sebgle/SolBuddy/README.md

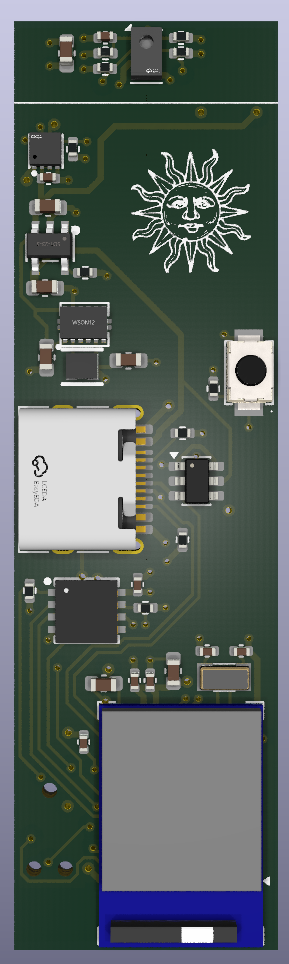
[picture p1: pcb/front_pcb.png]
Front of the pcb

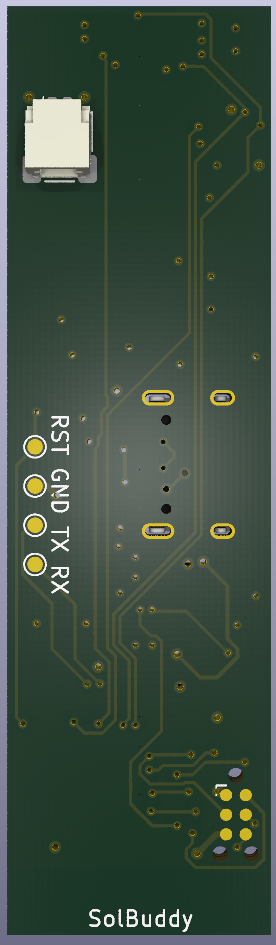
[picture p2: pcb/back_pcb.png]
Back of the pcb

Side of the pcb
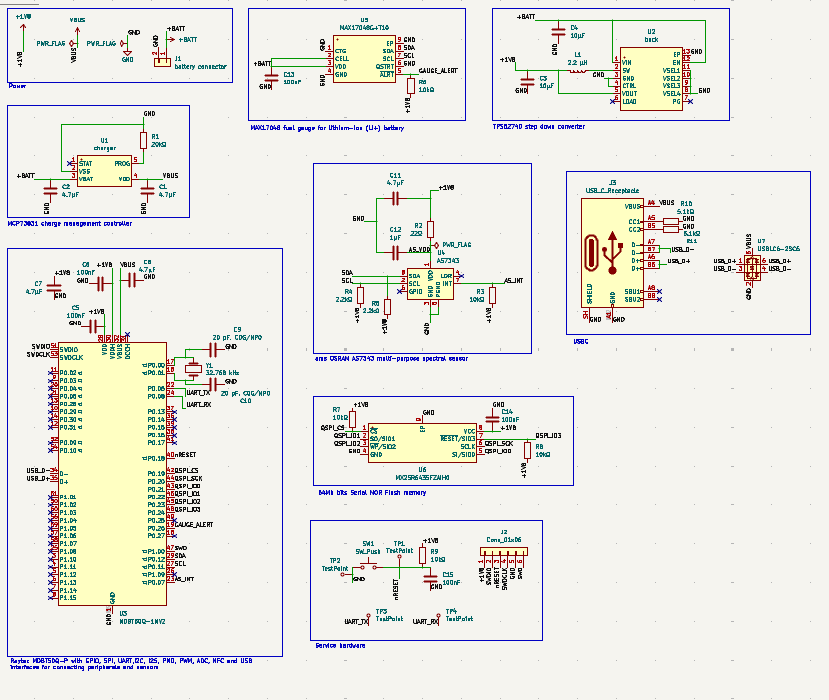
[picture p3: pcb/schematic.png]
Schematic

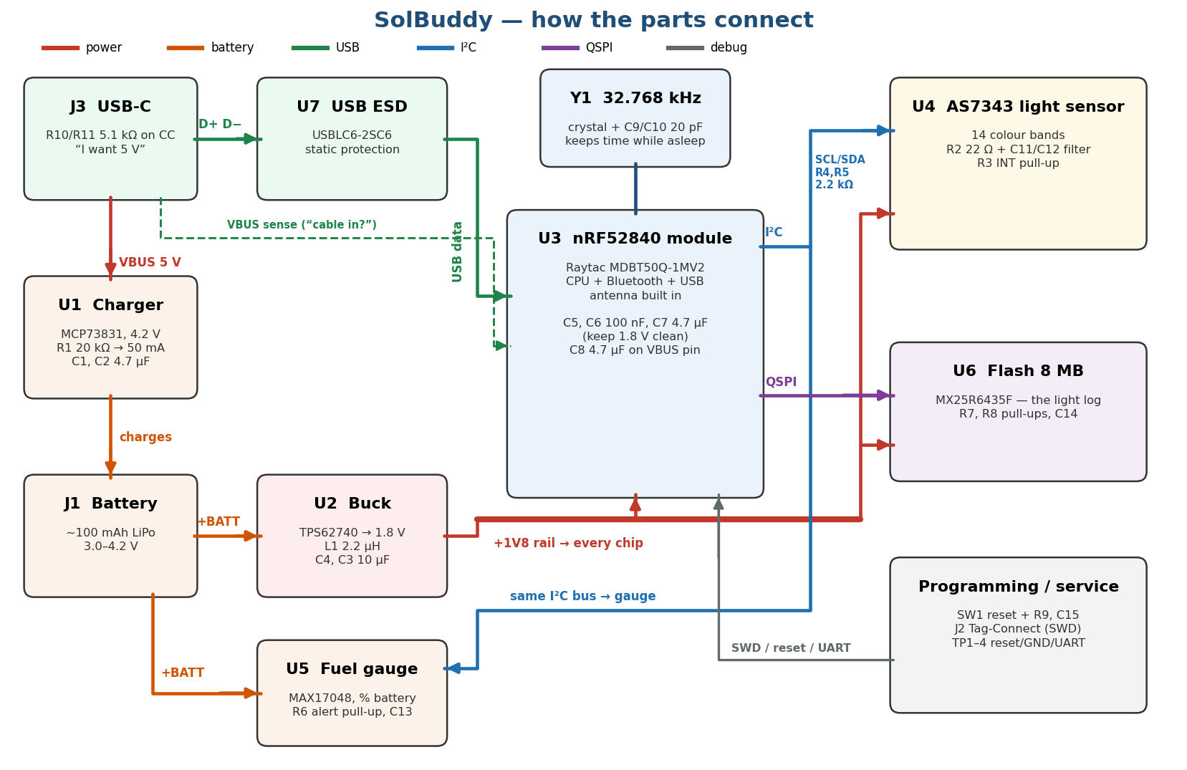
[picture p4: pcb/solbuddy_block_diagram.png]
Block diagram
