sebgle/SolBuddy/code/docs/solbuddy_software_diagram.png

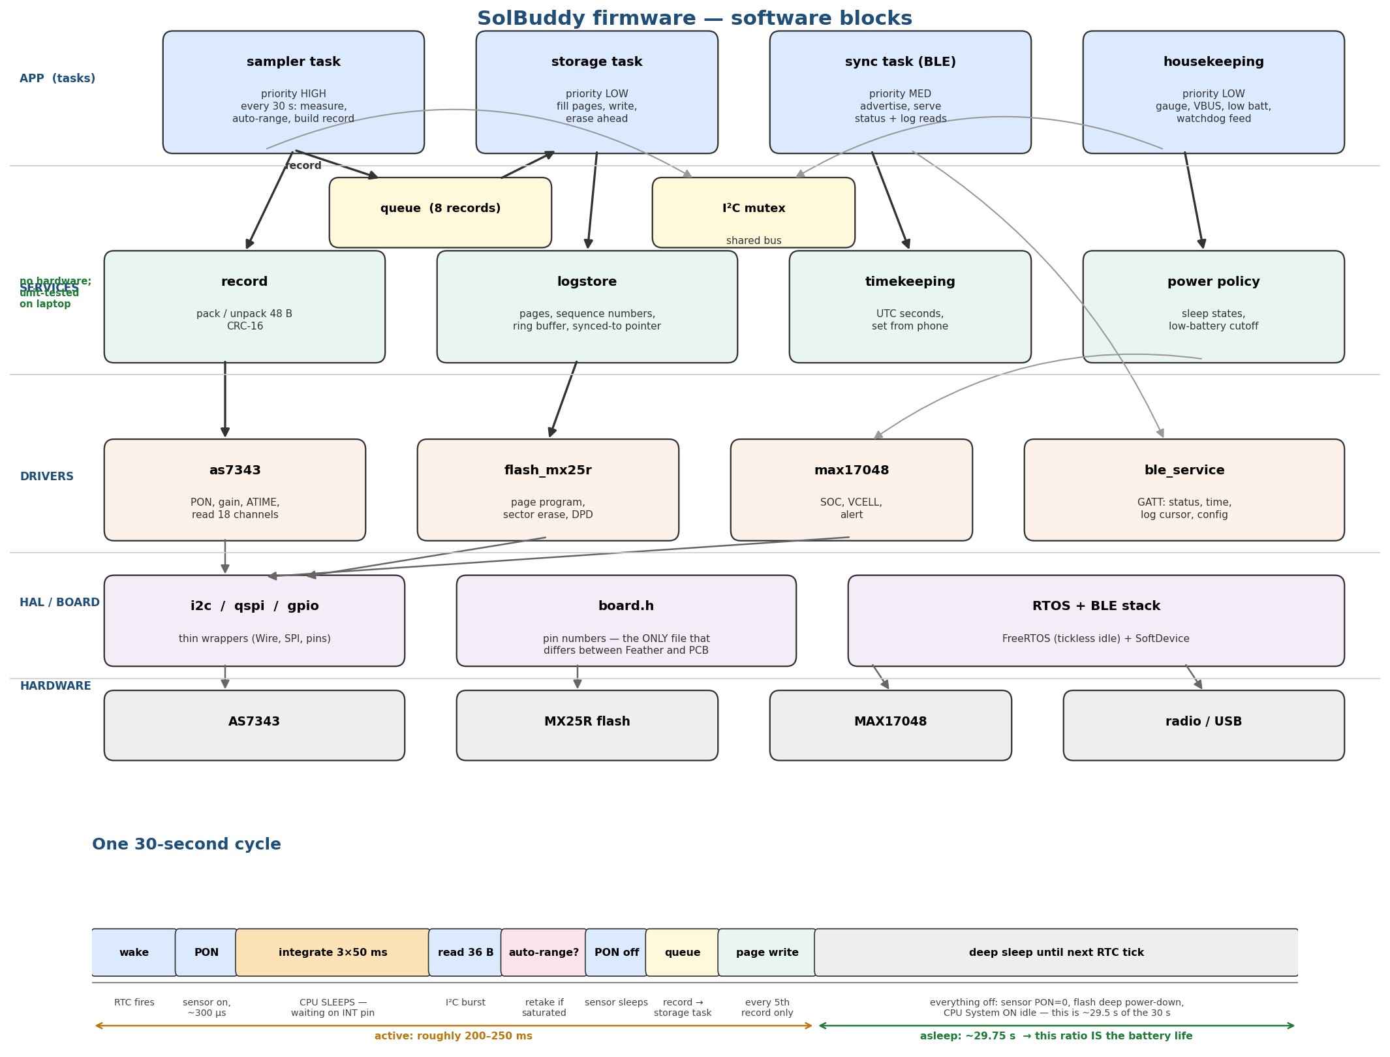
code/docs/solbuddy_software_diagram.png
