sebgle/SolBuddy/pcb/revA/revA.kicad_pcb

## KiCad design pcb/revA/revA.kicad_pcb (2026-09-25)

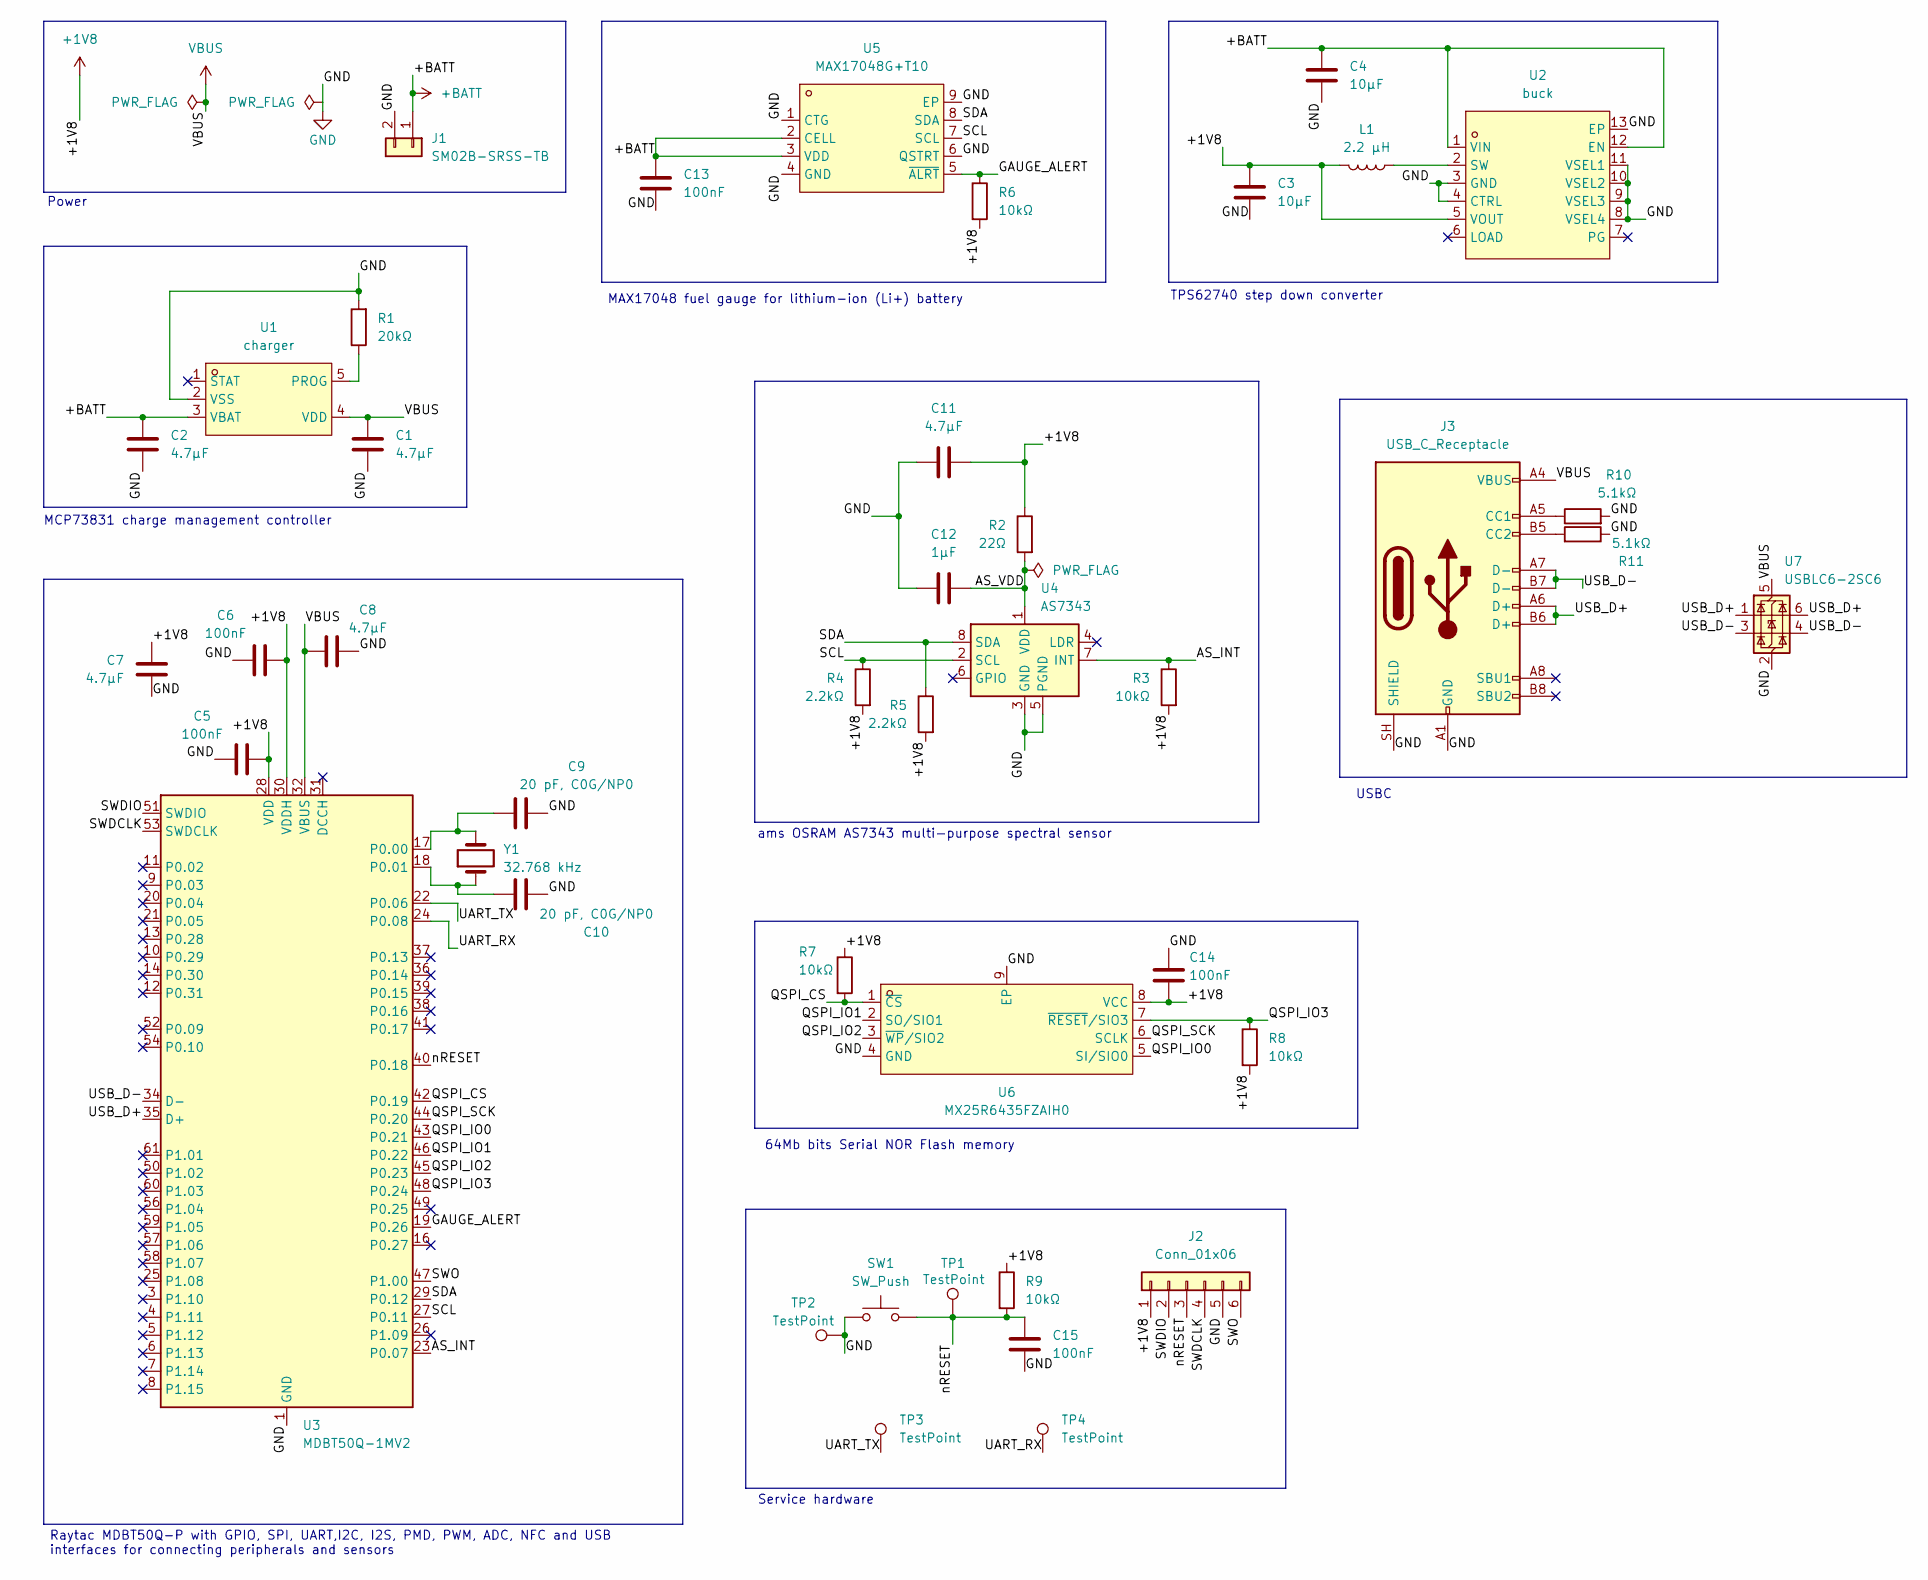
[picture p6: schematic revA.kicad_sch]

Parts:
C1, C2, C7, C8, C11: 4.7µF; C_0603_1608Metric; LCSC C19666
C3, C4: 10µF; C_0603_1608Metric; LCSC C96446
C5, C6, C13, C14, C15: 100nF; C_0402_1005Metric; LCSC C1525
C9, C10: 20 pF, C0G/NP0; C_0402_1005Metric; LCSC C1554
C12: 1µF; C_0402_1005Metric; LCSC C52923
J1: SM02B-SRSS-TB; JST_PH_S2B-PH-SM4-TB_1x02-1MP_P2.00mm_Horizontal; LCSC C295747
J2: Conn_01x06; Tag-Connect_TC2030-IDC-NL_2x03_P1.27mm_Vertical
J3: USB_C_Receptacle; USB_C_Receptacle_HRO_TYPE-C-31-M-12; LCSC C165948
L1: 2.2 µH; IND-SMD_L2.0-W1.6-B; LCSC C5832344
R1: 20kΩ; R_0402_1005Metric; LCSC C25765
R2: 22Ω; R_0402_1005Metric; LCSC C25092
R3, R6, R7, R8, R9: 10kΩ; R_0402_1005Metric; LCSC C25744
R4, R5: 2.2kΩ; R_0402_1005Metric; LCSC C25879
R10, R11: 5.1kΩ; R_0402_1005Metric; LCSC C25905
SW1: SW_Push; SW-SMD_L3.9-W3.0-P4.45; LCSC C720477
TP1, TP2, TP3, TP4: TestPoint; TestPoint_Pad_D1.0mm
U1: charger; SOT-23-5_L3.0-W1.7-P0.95-LS2.8-BL; MPN MCP73831T-2ACI/OT; LCSC C424093
U2: buck; WSON-12_L3.0-W2.0-P0.50-BL-EP; MPN TPS62740DSSR; LCSC C128606
U3: MDBT50Q-1MV2; Raytac_MDBT50Q; LCSC C5118826
U4: AS7343; AMS_OLGA-8_2x3.1mm_P0.8mm; LCSC C19085986
U5: MAX17048G+T10; TDFN-8_L2.0-W2.0-P0.50-BL-EP1.2; MPN MAX17048G+T10; LCSC C2682616
U6: MX25R6435FZAIH0; USON-8_L4.0-W4.0-P0.80-BL-EP; MPN MX25R6435FZAIH0; LCSC C2802846
U7: USBLC6-2SC6; SOT-23-6; LCSC C7519
Y1: 32.768 kHz; Crystal_SMD_3215-2Pin_3.2x1.5mm; LCSC C130253

Connections:
+1V8: C3.1, C5.1, C6.2, C7.2, C11.1, C14.2, J2.1, L1.2, R2.1, R3.2, R4.2, R5.2, R6.2, R7.1, R8.2, R9.1, U2.5 (VOUT), U3.28 (VDD), U3.30 (VDDH), U6.8 (VCC)
+BATT: C2.1, C4.1, C13.1, J1.1, U1.3 (VBAT), U2.1 (VIN), U2.12 (EN), U5.2 (CELL), U5.3 (VDD)
/AS_INT: R3.1, U3.23 (P0.07), U4.7 (INT)
/AS_VDD: C12.1, R2.2, U4.1 (VDD)
/GAUGE_ALERT: R6.1, U3.19 (P0.26), U5.5 (~ALRT)
/QSPI_CS: R7.2, U3.42 (P0.19), U6.1 (~CS)
/QSPI_IO0: U3.43 (P0.21), U6.5 (SI/SIO0)
/QSPI_IO1: U3.46 (P0.22), U6.2 (SO/SIO1)
/QSPI_IO2: U3.45 (P0.23), U6.3 (~WP/SIO2)
/QSPI_IO3: R8.1, U3.48 (P0.24), U6.7 (~RESET/SIO3)
/QSPI_SCK: U3.44 (P0.20), U6.6 (SCLK)
/SCL: R4.1, U3.27 (P0.11), U4.2 (SCL), U5.7 (SCL)
/SDA: R5.1, U3.29 (P0.12), U4.8 (SDA), U5.8 (SDA)
/SWDCLK: J2.4, U3.53 (SWDCLK)
/SWDIO: J2.2, U3.51 (SWDIO)
/SWO: J2.6, U3.47 (P1.00)
/UART_RX: TP4.1 (1_1), U3.24 (P0.08)
/UART_TX: TP3.1 (1_1), U3.22 (P0.06)
/USB_D+: J3.A6 (D+), J3.B6 (D+), U3.35 (D+), U7.1 (I/O1), U7.6 (I/O1)
/USB_D-: J3.A7 (D-), J3.B7 (D-), U3.34 (D-), U7.3 (I/O2), U7.4 (I/O2)
/nRESET: C15.1, J2.3, R9.2, SW1.2, TP1.1 (1_1), U3.40 (P0.18)
GND: C1.2, C2.2, C3.2, C4.2, C5.2, C6.1, C7.1, C8.2, C9.2, C10.2, C11.2, C12.2, C13.2, C14.1, C15.2, J1.2, J2.5, J3.A1 (GND), J3.A12 (GND), J3.B1 (GND), J3.B12 (GND), J3.SH (SHIELD), R1.2, R10.2, R11.1, SW1.1, TP2.1 (1_1), U1.2 (VSS), U2.3 (GND), U2.4 (CTRL), U2.8 (VSEL4), U2.9 (VSEL3), U2.10 (VSEL2), U2.11 (VSEL1), U2.13 (EP), U3.1 (GND), U3.2 (GND), U3.15 (GND), U3.33 (GND), U3.55 (GND), U4.3 (GND), U4.5 (PGND), U5.1 (CTG), U5.4 (GND), U5.6 (QSTRT), U5.9 (EP), U6.4 (GND), U6.9 (EP), U7.2 (GND)
unnamed: J3.A5 (CC1), R10.1
unnamed: J3.B5 (CC2), R11.2
unnamed: R1.1, U1.5 (PROG)
unnamed: L1.1, U2.2 (SW)
unnamed: C9.1, U3.17 (P0.00), Y1.2
unnamed: C10.1, U3.18 (P0.01), Y1.1
VBUS: C1.1, C8.1, J3.A4 (VBUS), J3.A9 (VBUS), J3.B4 (VBUS), J3.B9 (VBUS), U1.4 (VDD), U3.32 (VBUS), U7.5 (VBUS)

Notes on the sheet:
64Mb bits Serial NOR Flash memory
MAX17048 fuel gauge for lithium-ion (Li+) battery
USBC
ams OSRAM AS7343 multi-purpose spectral sensor
Service hardware
Power
TPS62740 step down converter
MCP73831 charge management controller
Raytac MDBT50Q-P with GPIO, SPI, UART,I2C, I2S, PMD, PWM, ADC, NFC and USB interfaces for connecting peripherals and sensors

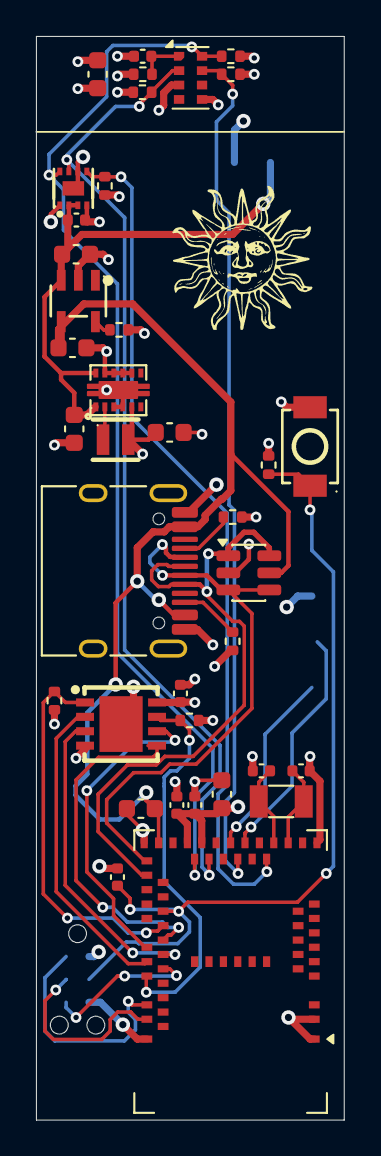
[picture p7: board revA.kicad_pcb from above]

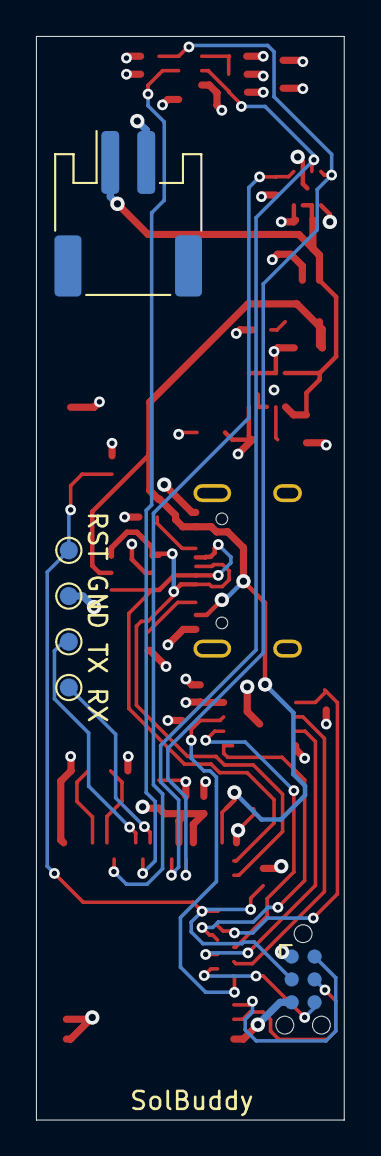
[picture p8: board revA.kicad_pcb from below]

Board: 4 copper layers, 17.1 x 60.2 mm, 43 parts (6 on the bottom side), 29 nets.
