sebgle/SolBuddy/code/SolBuddy/src/app/storage.h

#ifndef SOLBUDDY_APP_STORAGE_H
#define SOLBUDDY_APP_STORAGE_H

/*
 * The sample log on external flash: services/ringlog on top of
 * drivers/spi_nor. Keeps the flash in deep power-down between calls.
 *
 * Flash layout:
 *   sector 0 (4 KB)   reserved: calibration / device metadata (not the log)
 *   sector 1 .. end   ring log of 64-byte records
 */

#include <stdint.h>

#include "services/record.h"
#include "services/ringlog.h"

#ifdef __cplusplus
extern "C" {
#endif

typedef enum {
    STORAGE_OK = 0,
    STORAGE_ERR_FLASH,      /* chip missing/unknown, or a flash operation failed */
    STORAGE_NOT_AVAILABLE,  /* seq too old (overwritten) or not written yet */
    STORAGE_LOST            /* record damaged (e.g. power lost mid-write) */
} storage_result_t;

/* Identify the chip and find where the log left off. Call once at boot. */
storage_result_t storage_init(void);

/* Store a record; the log assigns rec->seq. */
storage_result_t storage_append(record_t *rec);

/* Read one record by sequence number. */
storage_result_t storage_read(uint32_t seq, record_t *rec);

/*
 * For BLE sync: copy up to max_records stored records, starting at *seq,
 * into out (64 bytes each, exactly as stored). Damaged records are skipped.
 * A *seq older than the oldest stored record starts at the oldest.
 * On return *count = records copied, *seq = next seq to ask for.
 * One flash session per call: other tasks wait at most one batch.
 */
storage_result_t storage_read_raw_batch(uint32_t *seq, uint8_t *out,
                                        uint32_t max_records, uint32_t *count);

/* Boot number for this boot: newest stored record's boot_id + 1 (0 if the
 * log is empty). Valid after storage_init. */
uint16_t storage_boot_id(void);

/* Range currently stored: [oldest, next). Empty when equal. */
uint32_t storage_oldest_seq(void);
uint32_t storage_next_seq(void);

#ifdef __cplusplus
}
#endif

#endif
