sebgle/SolBuddy/(commit log)

2026-09-11 BOM for first revision
2026-09-11 wrote basic as7343 sensor reading
2026-09-17 added a freeRTOS based program to simply test the reading capabilities of both sensors
2026-09-21 first pass for the PCB done
    [revA.kicad_pcb, revA.kicad_sch, revA_recovered_1518.kicad_sch]
2026-09-21 pcb images
2026-09-21 schematic img
2026-09-21 moved battery to the backside
    [revA.kicad_pcb, revA.kicad_sch]
2026-09-21 Untrack local KiCad backups, settings, and extension cache
    [revA.kicad_pcb, revA.kicad_sch, revA_recovered_1518.kicad_sch]
2026-09-22 initialized repo structure + generated a block diagram for the PCB
    [revA.kicad_pcb]
2026-09-25 outlined driver functions for AS7343
2026-09-25 outlined driver for AS7343
    [revA.kicad_pcb, revA.kicad_sch]
2026-10-01 wrote i2c driver for nrf52840 + tested with as7343 id check
2026-10-01 18 channel measurement for AS7343 driver
2026-10-01 per-board pin selection; QSPI pin decision and errata notes
    [board_pins.h]
2026-10-01 fuel gauge driver
2026-10-01 pull down IO1 — fixes random 50-280 ms ACTIVATE stall
    [clock.c, clock.h, main.cpp, qspi.c, record.c, record.h, storage.c, storage.h]
2026-10-02 BLE: protocol spec, Bluefruit bring-up, errata 244, protocol packing
    [ble.cpp, ble.h, main.cpp, protocol.c, protocol.h, storage.c]
